Chris-DHFProducts/Rp2040Matrix_14-03-2024/Draft_Manual/Images/Power_With_USB.jpg

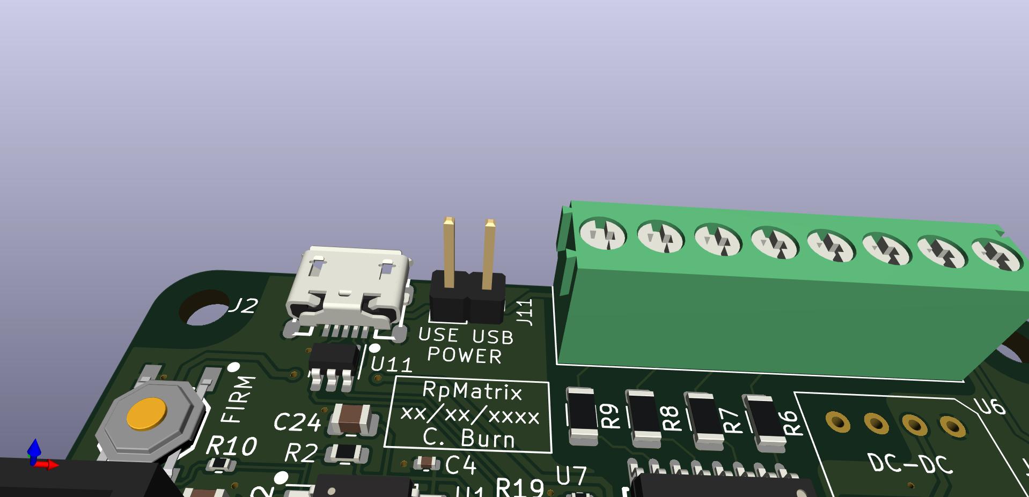
Draft_Manual/Images/Power_With_USB.jpg
