Chris-DHFProducts/Rp2040Matrix_14-03-2024/README.md

Notes: 
  The hardware and software is compatable with older board dated 02-21-2024.
  PBC files are saved with KiCad V8.0.1
