Chris-DHFProducts/Rp2040Matrix_14-03-2024/Draft_Manual/Images/Inputs.jpg

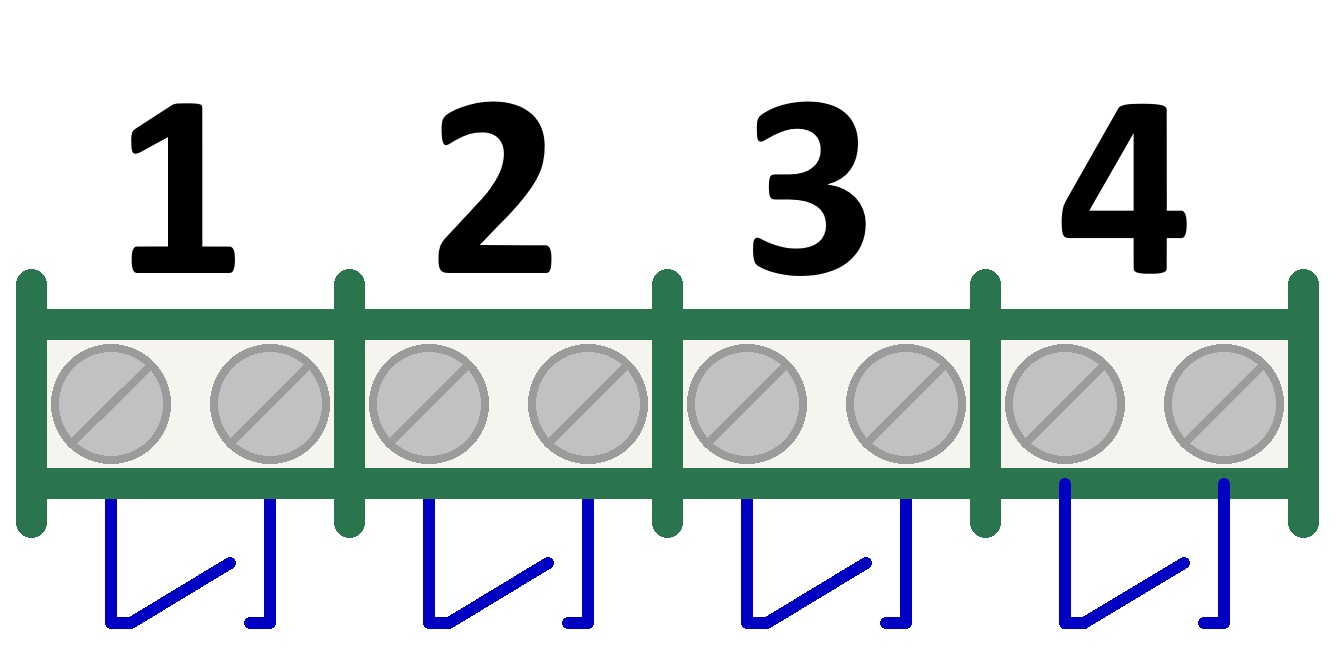
Draft_Manual/Images/Inputs.jpg
