Chris-DHFProducts/Rp2040Matrix_14-03-2024/Hardware/Rp2040Matrix_14-03-2024.kicad_pcb

## KiCad design Hardware/Rp2040Matrix_14-03-2024.kicad_pcb (2024-03-17)

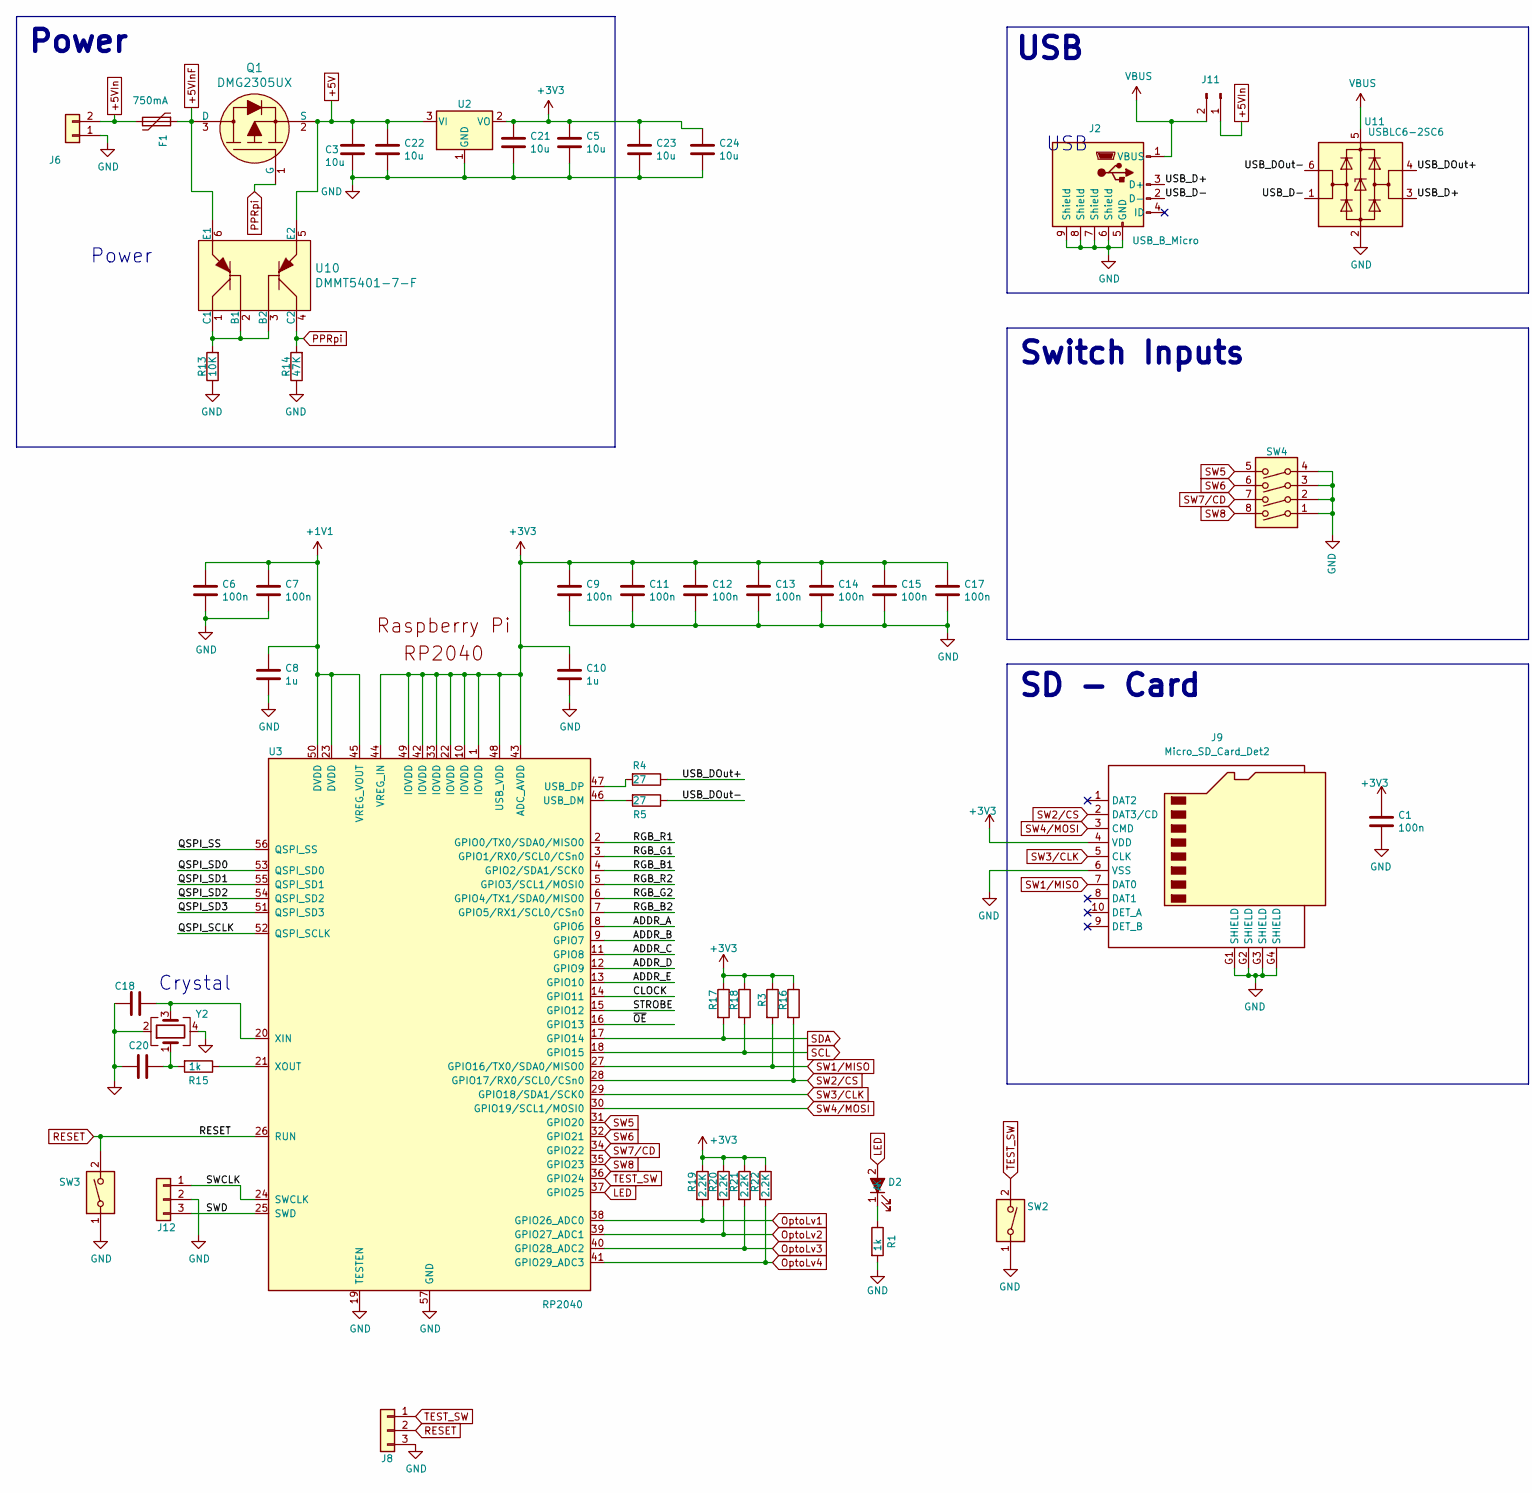
[picture p3: schematic Rp2040Matrix_14-03-2024.kicad_sch, part in row 1, column 1]

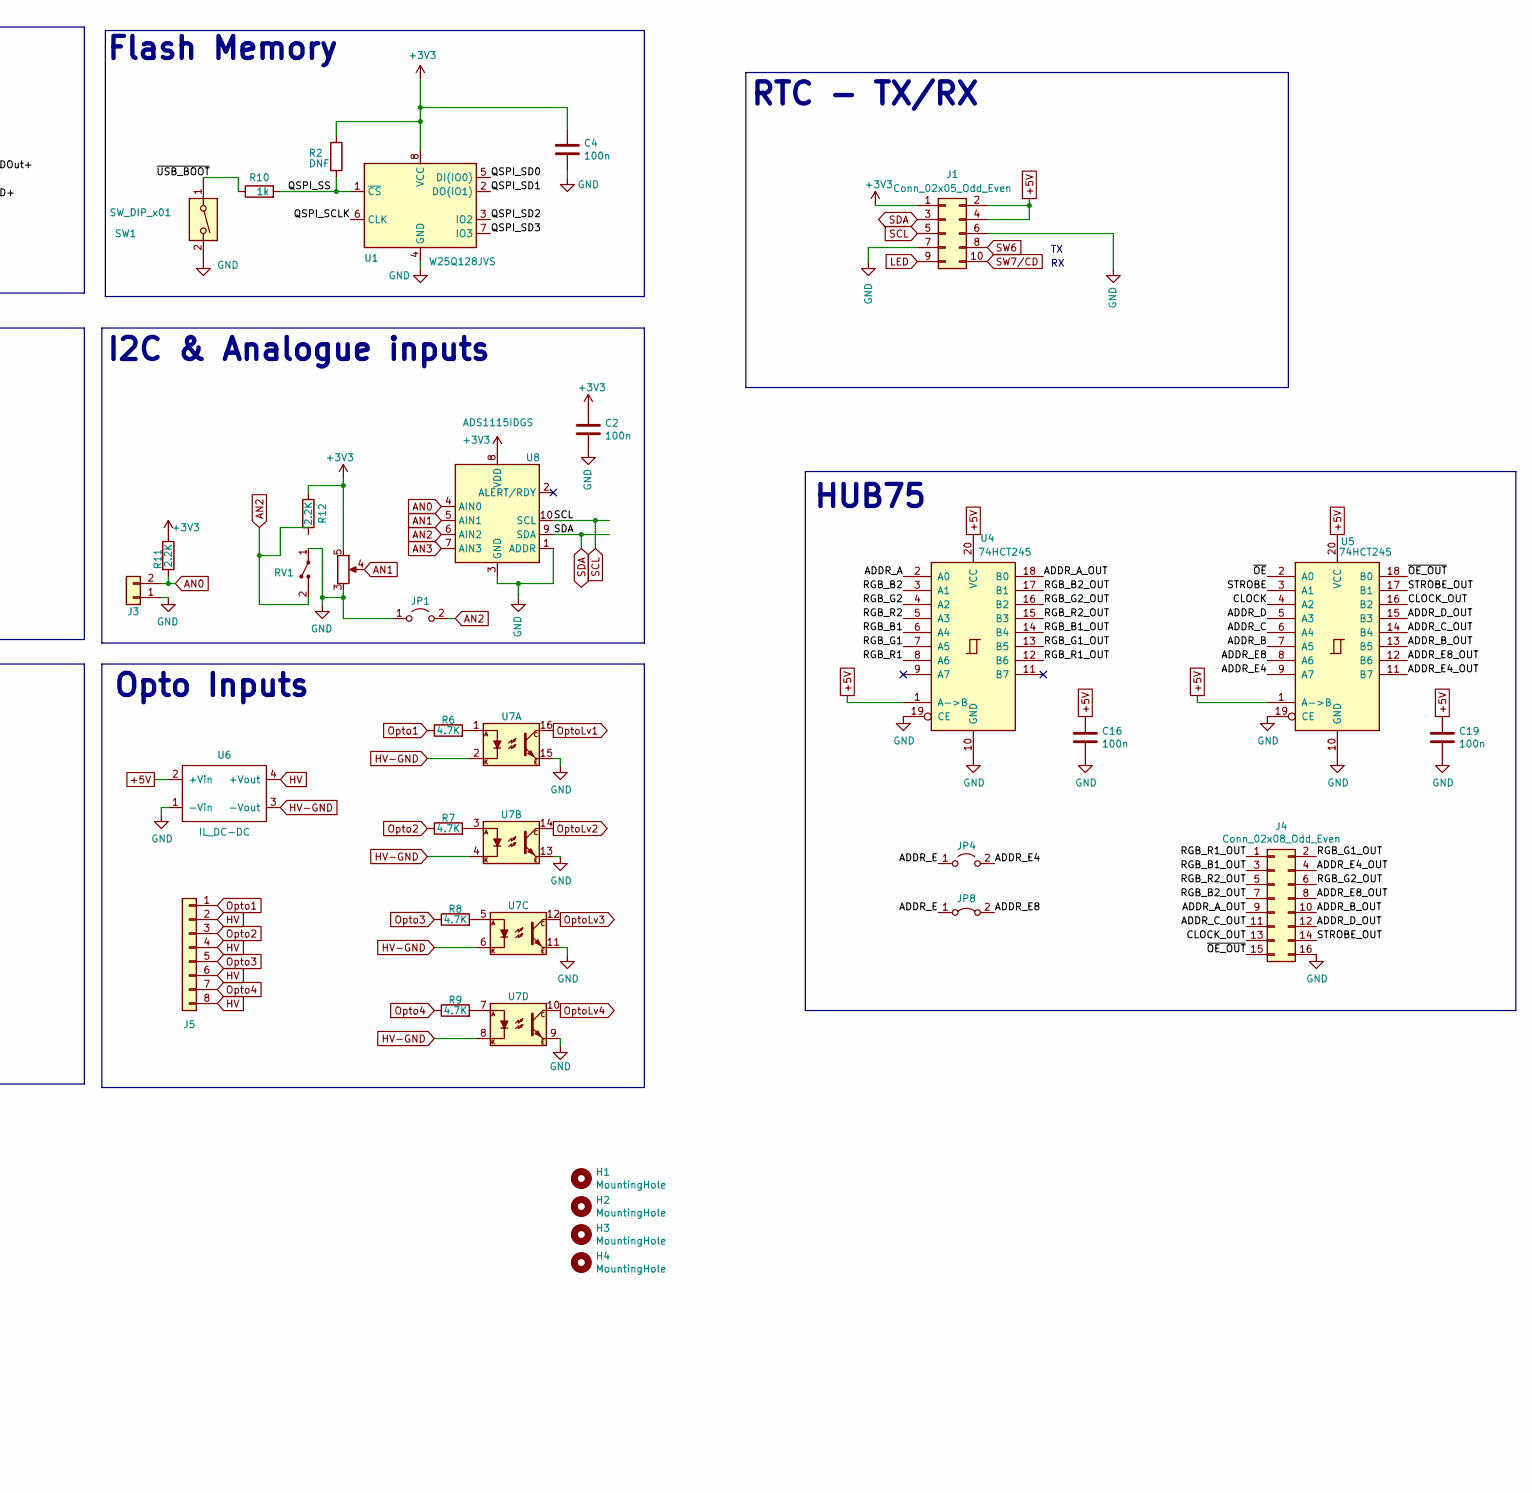
[picture p4: schematic Rp2040Matrix_14-03-2024.kicad_sch, part in row 1, column 2]

Parts:
C1, C2, C4, C6, C7, C9, C11, C12, C13, C14, C15, C16, C17, C19: 100n; C_0402_1005Metric; MPN CL05B104KO5NNNC; LCSC C1525
C3, C5, C21, C22, C23, C24: 10u; C_0805_2012Metric; MPN CL21A106KAYNNNE; LCSC C15850
C8, C10: 1u; C_0402_1005Metric; MPN CL05A105KA5NQNC; LCSC C52923
C18, C20: 30p; C_0402_1005Metric; MPN 0402CG300F500NT; LCSC C913871
D2: Red LED 0603; LED0603-R-RD; MPN NCD0603R1; LCSC C84263
F1: 750mA; Fuse_1812_4532Metric; MPN BSMD1812-075-33V; LCSC C883146
H1, H2, H3, H4: MountingHole; MountingHole_3.2mm_M3
J1: Conn_02x05_Odd_Even; PinHeader_2x05_P2.54mm_Vertical
J2: USB_B_Micro; MICRO-USB-SMD_MICRO-USB-A17; MPN U-F-M5DD-W-2; LCSC C145793
J3, J6: Conn_01x02_Male; TerminalBlock_Phoenix_PT-1,5-2-3.5-H_1x02_P3.50mm_Horizontal; MPN DB125-3.5-2P-GN-S; LCSC C466970
J4: Conn_02x08_Odd_Even; IDC-Header_2x08_P2.54mm_Vertical; MPN 321016SG0ABK00A01; LCSC C429960
J5: Conn_01x08_Male; TerminalBlock_Phoenix_PT-1,5-8-3.5-H_1x08_P3.50mm_Horizontal; MPN DB125-3.5-8P-GN-S; LCSC C5184954
J8, J12: Conn_01x03_Male; PinHeader_1x03_P2.54mm_Vertical; MPN 12251103CNG0S115001; LCSC C429954
J9: Micro_SD_Card_Det2; MOLEX_104031-0811; MPN 1040310811; LCSC C585350
J11: Conn_01x02_Male; PinHeader_1x02_P2.54mm_Vertical; MPN PH-01078; LCSC Liansheng
JP1, JP4: Jumper_2_Open; SolderJumper-2_P1.3mm_Open_RoundedPad1.0x1.5mm
JP8: Jumper_2_Bridged; SolderJumper-2_P1.3mm_Bridged_RoundedPad1.0x1.5mm
Q1: DMG2305UX; SOT-23; MPN DMG2305UX-7; LCSC C150470
R1, R10, R15: 1k; R_0402_1005Metric; MPN 0402WGF1001TCE; LCSC C11702
R2: DNF; R_0603_1608Metric
R3, R11, R12, R16, R17, R18, R19, R20, R21, R22: 2.2K; R_0402_1005Metric; MPN 0402WGF2201TCE; LCSC C25879
R4, R5: 27; R_0402_1005Metric; MPN RC0402FR-0727RL; LCSC C138021
R6, R7, R8, R9: 4.7K; R_1206_3216Metric; MPN 1206W4F4701T5E; LCSC C17936
R13: 10K; R_0402_1005Metric; MPN 0402WGF1002TCE; LCSC C25744
R14: 47K; R_0402_1005Metric; MPN 0402WGF4702TCE; LCSC C25792
RV1: R_Pot+SW; AM-Pot_01
SW1, SW2, SW3: SW_DIP_x01; SW-SMD_4P-L5.1-W5.1-P3.70-LS6.5-TL-2; MPN TS-1187A-B-A-B; LCSC C318884
SW4: Conn_01x04_Male; SW_DIP_SPSTx04_Slide_Omron_A6S-410x_W8.9mm_P2.54mm; LCSC C2842911
U1: W25Q128JVS; SOIC-8_5.23x5.23mm_P1.27mm; MPN W25Q128JVSIQ; LCSC C97521
U2: Voltage Regulator Fixed 3.3V; SOT-223-3_TabPin2; MPN AMS1117-3.3; LCSC C6186
U3: RP2040; RP2040-QFN-56; MPN RP2040; LCSC C2040
U4, U5: 74HCT245; TSSOP-20_4.4x6.5mm_P0.65mm; MPN SN74HCT245PWR; LCSC C6779
U6: IL_DC-DC; IL-DC-DC-XP; MPN IE0524S; Farnell 2084318
U7: OPTO-TRANSISTOR-4; SOP-16_L10.3-W4.4-P1.27-LS7.0-BL; MPN TLP291; LCSC C60900
U8: ADS1115IDGS; VSSOP-10_3x3mm_P0.5mm; MPN ADS1115IDGSR; LCSC C37593
U10: DMMT5401-7-F; MPN DMMT5401-7-F; LCSC C154733
U11: USBLC6-2SC6; SOT-23-6; MPN TPUSBLC6-2SC6; LCSC C558442
Y2: Crystal_GND24; Crystal YSX321SL; MPN TX322512M4LBCE2T; LCSC C5182760

Connections:
+1V1: C6.1, C7.1, C8.1, U3.23 (DVDD), U3.45 (VREG_VOUT), U3.50 (DVDD)
+3V3: C1.1, C2.1, C4.1, C5.1, C9.1, C10.1, C11.1, C12.1, C13.1, C14.1, C15.1, C17.1, C21.1, C23.1, C24.1, J1.1, J9.4 (VDD), R2.1, R3.1, R11.1, R12.1, R16.1, R17.1, R18.1, R19.1, R20.1, R21.1, R22.1, RV1.5, U1.8 (VCC), U2.2 (VO), U3.1 (IOVDD), U3.10 (IOVDD), U3.22 (IOVDD), U3.33 (IOVDD), U3.42 (IOVDD), U3.43 (ADC_AVDD), U3.44 (VREG_IN), U3.48 (USB_VDD), U3.49 (IOVDD), U8.8 (VDD)
+5V: C3.1, C16.1, C19.1, C22.1, J1.2, J1.4, Q1.2 (S), U2.3 (VI), U4.1 (A->B), U4.20 (VCC), U5.1 (A->B), U5.20 (VCC), U6.2 (+Vin), U10.5 (E2)
+5VIn: F1.2, J6.2, J11.1
+5VInF: F1.1, Q1.3 (D), U10.6 (E1)
/ADDR_A: U3.8 (GPIO6), U4.2 (A0)
/ADDR_A_OUT: J4.9, U4.18 (B0)
/ADDR_B: U3.9 (GPIO7), U5.7 (A5)
/ADDR_B_OUT: J4.10, U5.13 (B5)
/ADDR_C: U3.11 (GPIO8), U5.6 (A4)
/ADDR_C_OUT: J4.11, U5.14 (B4)
/ADDR_D: U3.12 (GPIO9), U5.5 (A3)
/ADDR_D_OUT: J4.12, U5.15 (B3)
/ADDR_E: JP4.1 (A), JP8.1 (A), U3.13 (GPIO10)
/ADDR_E4: JP4.2 (B), U5.9 (A7)
/ADDR_E4_OUT: J4.4, U5.11 (B7)
/ADDR_E8: JP8.2 (B), U5.8 (A6)
/ADDR_E8_OUT: J4.8, U5.12 (B6)
/CLOCK: U3.14 (GPIO11), U5.4 (A2)
/CLOCK_OUT: J4.13, U5.16 (B2)
/QSPI_SCLK: U1.6 (CLK), U3.52 (QSPI_SCLK)
/QSPI_SD0: U1.5 (DI(IO0)), U3.53 (QSPI_SD0)
/QSPI_SD1: U1.2 (DO(IO1)), U3.55 (QSPI_SD1)
/QSPI_SD2: U1.3 (IO2), U3.54 (QSPI_SD2)
/QSPI_SD3: U1.7 (IO3), U3.51 (QSPI_SD3)
/QSPI_SS: R2.2, R10.2, U1.1 (~CS), U3.56 (QSPI_SS)
/RGB_B1: U3.4 (GPIO2/SDA1/SCK0), U4.6 (A4)
/RGB_B1_OUT: J4.3, U4.14 (B4)
/RGB_B2: U3.7 (GPIO5/RX1/SCL0/CSn0), U4.3 (A1)
/RGB_B2_OUT: J4.7, U4.17 (B1)
/RGB_G1: U3.3 (GPIO1/RX0/SCL0/CSn0), U4.7 (A5)
/RGB_G1_OUT: J4.2, U4.13 (B5)
/RGB_G2: U3.6 (GPIO4/TX1/SDA0/MISO0), U4.4 (A2)
/RGB_G2_OUT: J4.6, U4.16 (B2)
/RGB_R1: U3.2 (GPIO0/TX0/SDA0/MISO0), U4.8 (A6)
/RGB_R1_OUT: J4.1, U4.12 (B6)
/RGB_R2: U3.5 (GPIO3/SCL1/MOSI0), U4.5 (A3)
/RGB_R2_OUT: J4.5, U4.15 (B3)
/STROBE: U3.15 (GPIO12), U5.3 (A1)
/STROBE_OUT: J4.14, U5.17 (B1)
/SWCLK: J12.1, U3.24 (SWCLK)
/SWD: J12.3, U3.25 (SWD)
/USB_D+: J2.3 (D+), U11.3 (I/O2)
/USB_D-: J2.2 (D-), U11.1 (I/O1)
/USB_DOut+: R4.1, U11.4 (I/O2)
/USB_DOut-: R5.1, U11.6 (I/O1)
/~OE_OUT: J4.15, U5.18 (B0)
/~OE: U3.16 (GPIO13), U5.2 (A0)
/~USB_BOOT: R10.1, SW1.1
AN0: J3.2, R11.2, U8.4 (AIN0)
AN1: RV1.4, U8.5 (AIN1)
AN2: JP1.2 (B), RV1.2, U8.6 (AIN2)
AN3: U8.7 (AIN3)
GND: C1.2, C2.2, C3.2, C4.2, C5.2, C6.2, C7.2, C8.2, C9.2, C10.2, C11.2, C12.2, C13.2, C14.2, C15.2, C16.2, C17.2, C18.1, C19.2, C20.1, C21.2, C22.2, C23.2, C24.2, J1.6, J1.7, J2.5 (GND), J2.6 (Shield), J2.7 (Shield), J2.8 (Shield), J2.9 (Shield), J3.1, J4.16, J6.1, J8.3, J9.6 (VSS), J9.G1 (SHIELD), J9.G2 (SHIELD), J9.G3 (SHIELD), J9.G4 (SHIELD), J12.2, JP1.1 (A), R1.2, R13.1, R14.1, RV1.1, RV1.3, SW1.2, SW2.1, SW3.1, SW4.1, SW4.2, SW4.3, SW4.4, U1.4 (GND), U2.1 (GND), U3.19 (TESTEN), U3.57 (GND), U4.10 (GND), U4.19 (CE), U5.10 (GND), U5.19 (CE), U6.1 (-Vin), U7.9, U7.11, U7.13, U7.15, U8.1 (ADDR), U8.3 (GND), U11.2 (GND), Y2.2, Y2.4
HV: J5.2, J5.4, J5.6, J5.8, U6.4 (+Vout)
HV-GND: U6.3 (-Vout), U7.2, U7.4, U7.6, U7.8
LED: D2.2 (A), J1.9, U3.37 (GPIO25)
unnamed: C20.2, R15.2, Y2.1
unnamed: D2.1 (K), R1.1
unnamed: R6.2, U7.1
unnamed: R7.2, U7.3
unnamed: R8.2, U7.5
unnamed: R9.2, U7.7
unnamed: R5.2, U3.46 (USB_DM)
unnamed: R4.2, U3.47 (USB_DP)
unnamed: C18.2, U3.20 (XIN), Y2.3
unnamed: R15.1, U3.21 (XOUT)
unnamed: R13.2, U10.1 (C1), U10.2 (B1), U10.3 (B2)
Opto1: J5.1, R6.1
Opto2: J5.3, R7.1
Opto3: J5.5, R8.1
Opto4: J5.7, R9.1
OptoLv1: R19.2, U3.38 (GPIO26_ADC0), U7.16
OptoLv2: R20.2, U3.39 (GPIO27_ADC1), U7.14
OptoLv3: R21.2, U3.40 (GPIO28_ADC2), U7.12
OptoLv4: R22.2, U3.41 (GPIO29_ADC3), U7.10
PPRpi: Q1.1 (G), R14.2, U10.4 (C2)
RESET: J8.2, SW3.2, U3.26 (RUN)
SCL: J1.5, R18.2, U3.18 (GPIO15), U8.10 (SCL)
SDA: J1.3, R17.2, U3.17 (GPIO14), U8.9 (SDA)
SW1/MISO: J9.7 (DAT0), R3.2, U3.27 (GPIO16/TX0/SDA0/MISO0)
SW2/CS: J9.2 (DAT3/CD), R16.2, U3.28 (GPIO17/RX0/SCL0/CSn0)
SW3/CLK: J9.5 (CLK), U3.29 (GPIO18/SDA1/SCK0)
SW4/MOSI: J9.3 (CMD), U3.30 (GPIO19/SCL1/MOSI0)
SW5: SW4.5, U3.31 (GPIO20)
SW6: J1.8, SW4.6, U3.32 (GPIO21)
SW7/CD: J1.10, SW4.7, U3.34 (GPIO22)
SW8: SW4.8, U3.35 (GPIO23)
TEST_SW: J8.1, SW2.2, U3.36 (GPIO24)
VBUS: J2.1 (VBUS), J11.2, U11.5 (VBUS)

Notes on the sheet:
Power
Switch Inputs
I2C & Analogue inputs
SD - Card
Opto Inputs
HUB75
USB
Flash Memory
RTC - TX/RX
Crystal

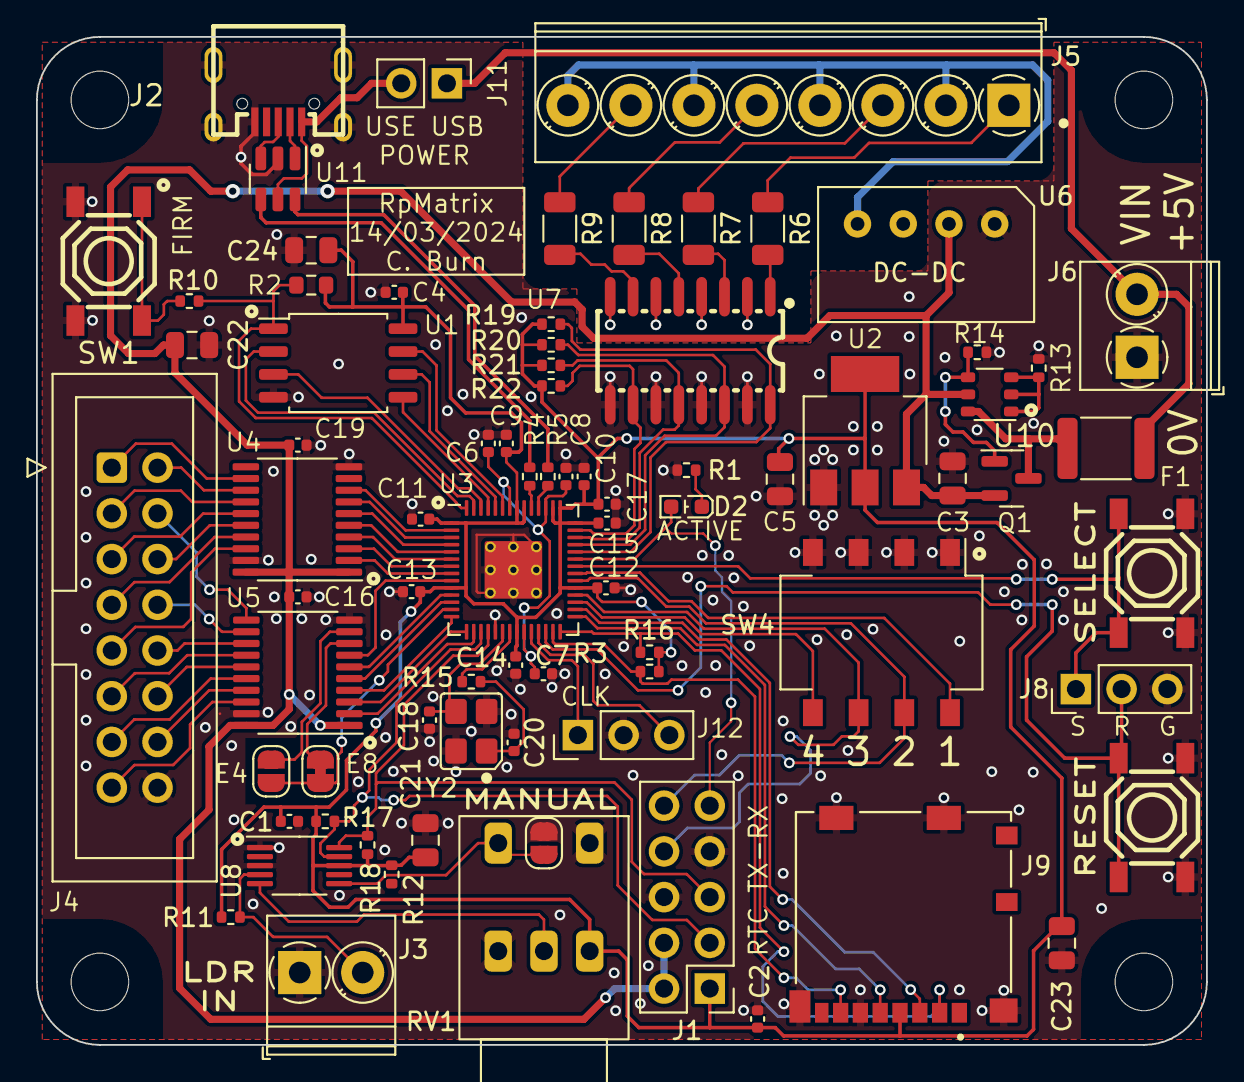
[picture p5: board Rp2040Matrix_14-03-2024.kicad_pcb from above]

Board: 2 copper layers, 65.0 x 56.0 mm, 82 parts (0 on the bottom side), 89 nets.
